benjamarle/supercar/(commit log)

2021-09-28 First draft version
    [partitionTable.csv]
2021-10-21 KiCad general schema
    [supercar.kicad_pcb, supercar.sch]
2021-10-21 Mode + power
    The mode is now implemented SWAY / MOTION
    Reversing the physical switch with the remote when pressing A
    Power kill switch to cut the motors
    [supercar_main.c, supercar_main.h]
2021-10-21 Progressive motor start
    WIP
2021-10-22 Change direction when the sign of the throttle changes
2021-10-22 Fix for the steering with signed throttle
    The direction of the physical switch can be reversed with the remote
    [supercar_main.c, supercar_main.h]
2021-10-23 Main mutex for the car
    When the control type goes back to local, set the mode of the car based of the physical switch
    Read the state of the physical switch when initiating the car
    Stop the car before reversing and restart it if it was running so that the kid doesn't have to depress the accelerator
    [supercar_main.c, supercar_main.h]
2021-10-24 Fix for the mode application
    [supercar_main.c, supercar_main.h]
2021-10-27 Direction is now a derivated value from the sign of the throttle
2021-12-05 Persistant configuration with REST API
    [partitionTable.csv]
2021-12-05 Parking sensors
